Sauski/Talon/kicad-slim/images/hand.png

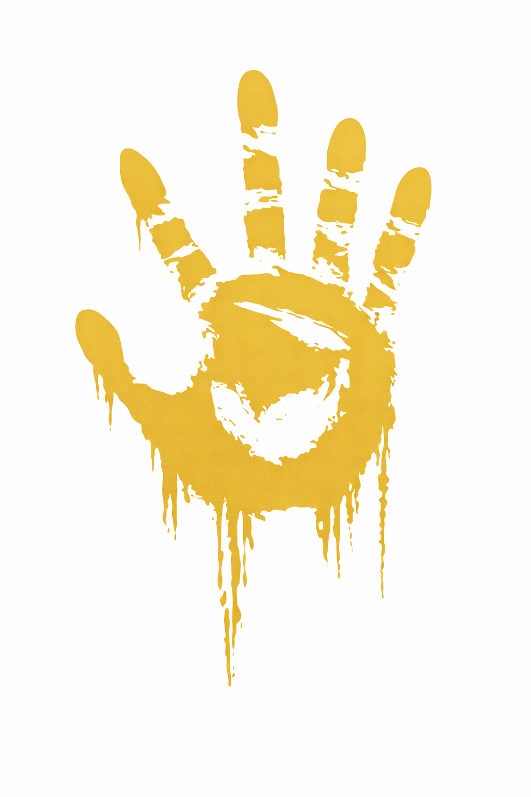
kicad-slim/images/hand.png
