Sauski/Talon/freecad/talon.FCStd

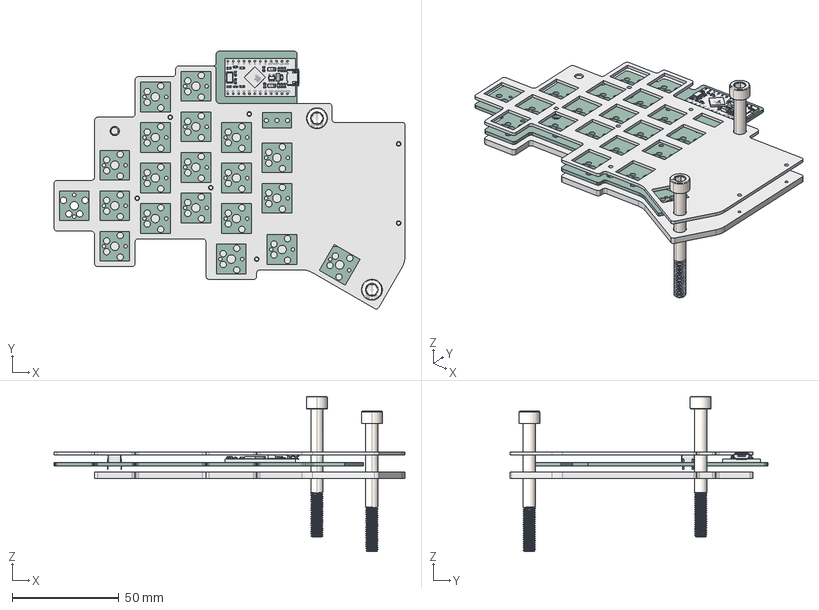
[picture p2: CAD file, 2024-05-12]
freecad/talon.FCStd
164.5 x 120.9 x 72.7 mm
Keyplate_Extrude
Baseplate_Extrude
ARDUINO PRO MICRO
SW_PUSH_6mm
talon PCB
Socket cap head bolt - short thread M6x60
Socket cap head bolt - short thread M6x061
