Sauski/Talon/kicad-slim/models/SSSS811101.step

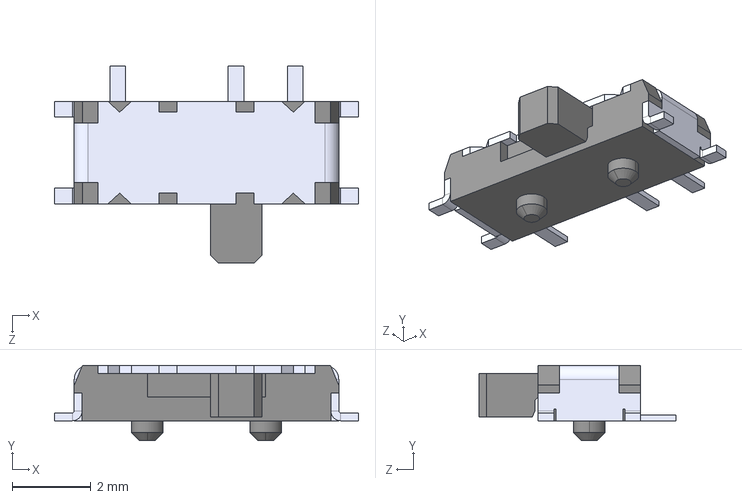
[picture p3: CAD file, 2025-10-08]
kicad-slim/models/SSSS811101.step
7.70 x 1.90 x 5.00 mm
