Sauski/Talon/freecad/talon-Keyplate_Extrude.step

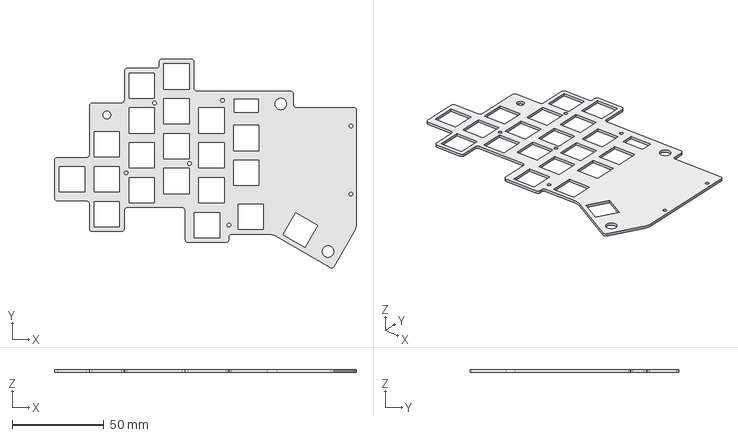
[picture p4: CAD file, 2024-05-01]
freecad/talon-Keyplate_Extrude.step
164.5 x 113.9 x 1.50 mm
