Sauski/Talon/kicad-slim/models/cherry_r2_1_25u.step

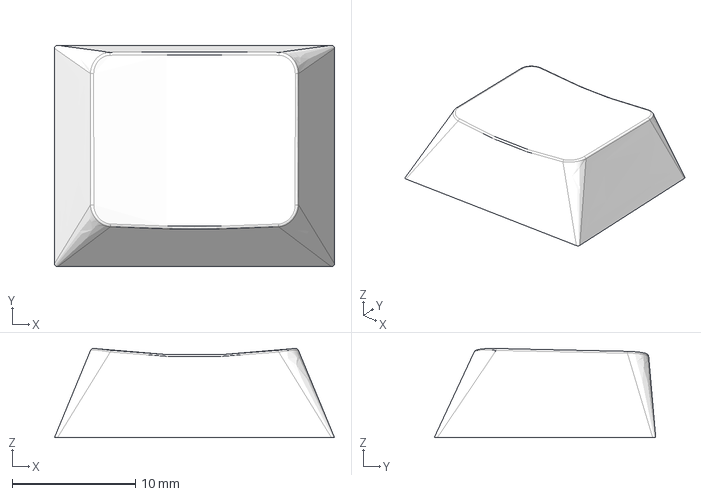
[picture p5: CAD file, 2024-04-27]
kicad-slim/models/cherry_r2_1_25u.step
22.8 x 18.0 x 7.24 mm
