Sauski/Talon/freecad/talon-Baseplate_Extrude.step

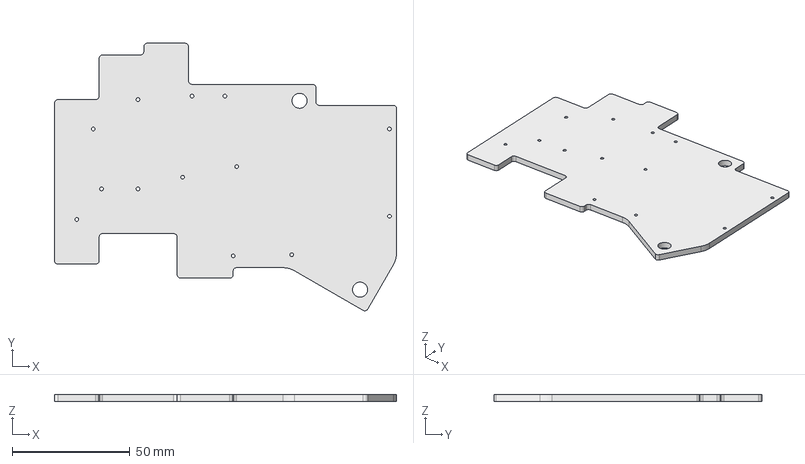
[picture p6: CAD file, 2024-05-01]
freecad/talon-Baseplate_Extrude.step
145.5 x 113.9 x 3.00 mm
