Sauski/Talon/kicad-slim/models/cherry_r2_1u.step

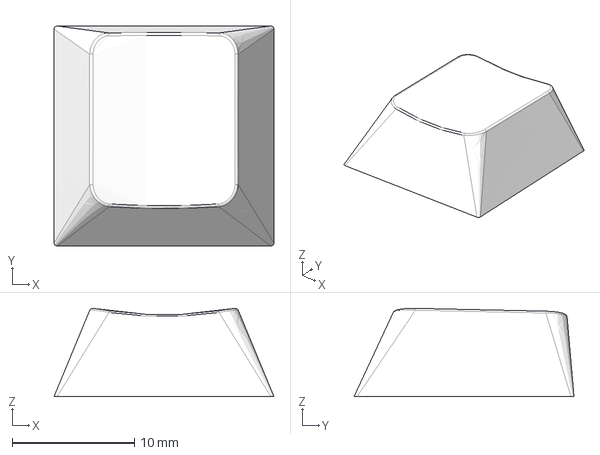
[picture p7: CAD file, 2024-04-27]
kicad-slim/models/cherry_r2_1u.step
18.0 x 18.0 x 7.23 mm
