Sauski/Talon/kicad-slim/models/cherry_r2_1_5u.step

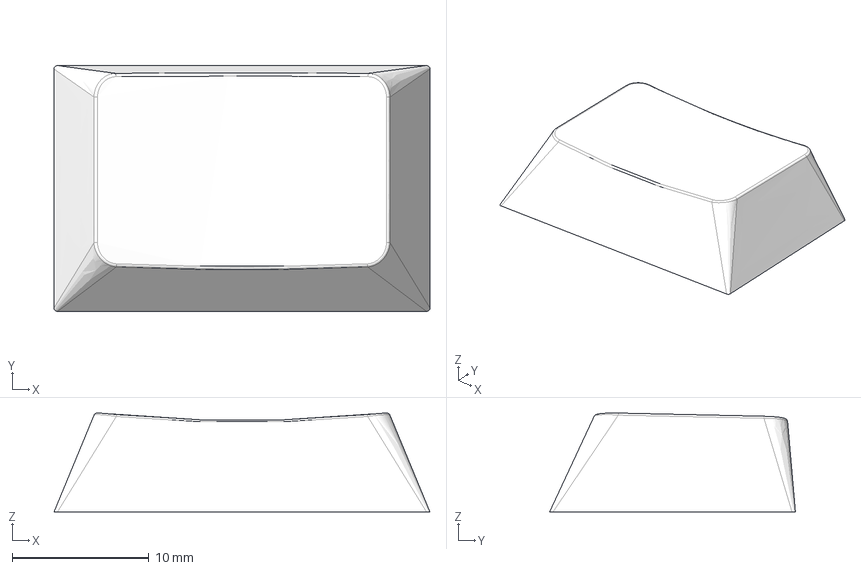
[picture p8: CAD file, 2024-04-27]
kicad-slim/models/cherry_r2_1_5u.step
27.5 x 18.0 x 7.25 mm
