Sauski/Talon/kicad-slim/talon_slim.kicad_pcb

## KiCad design kicad-slim/talon_slim.kicad_pcb (2026-01-20)

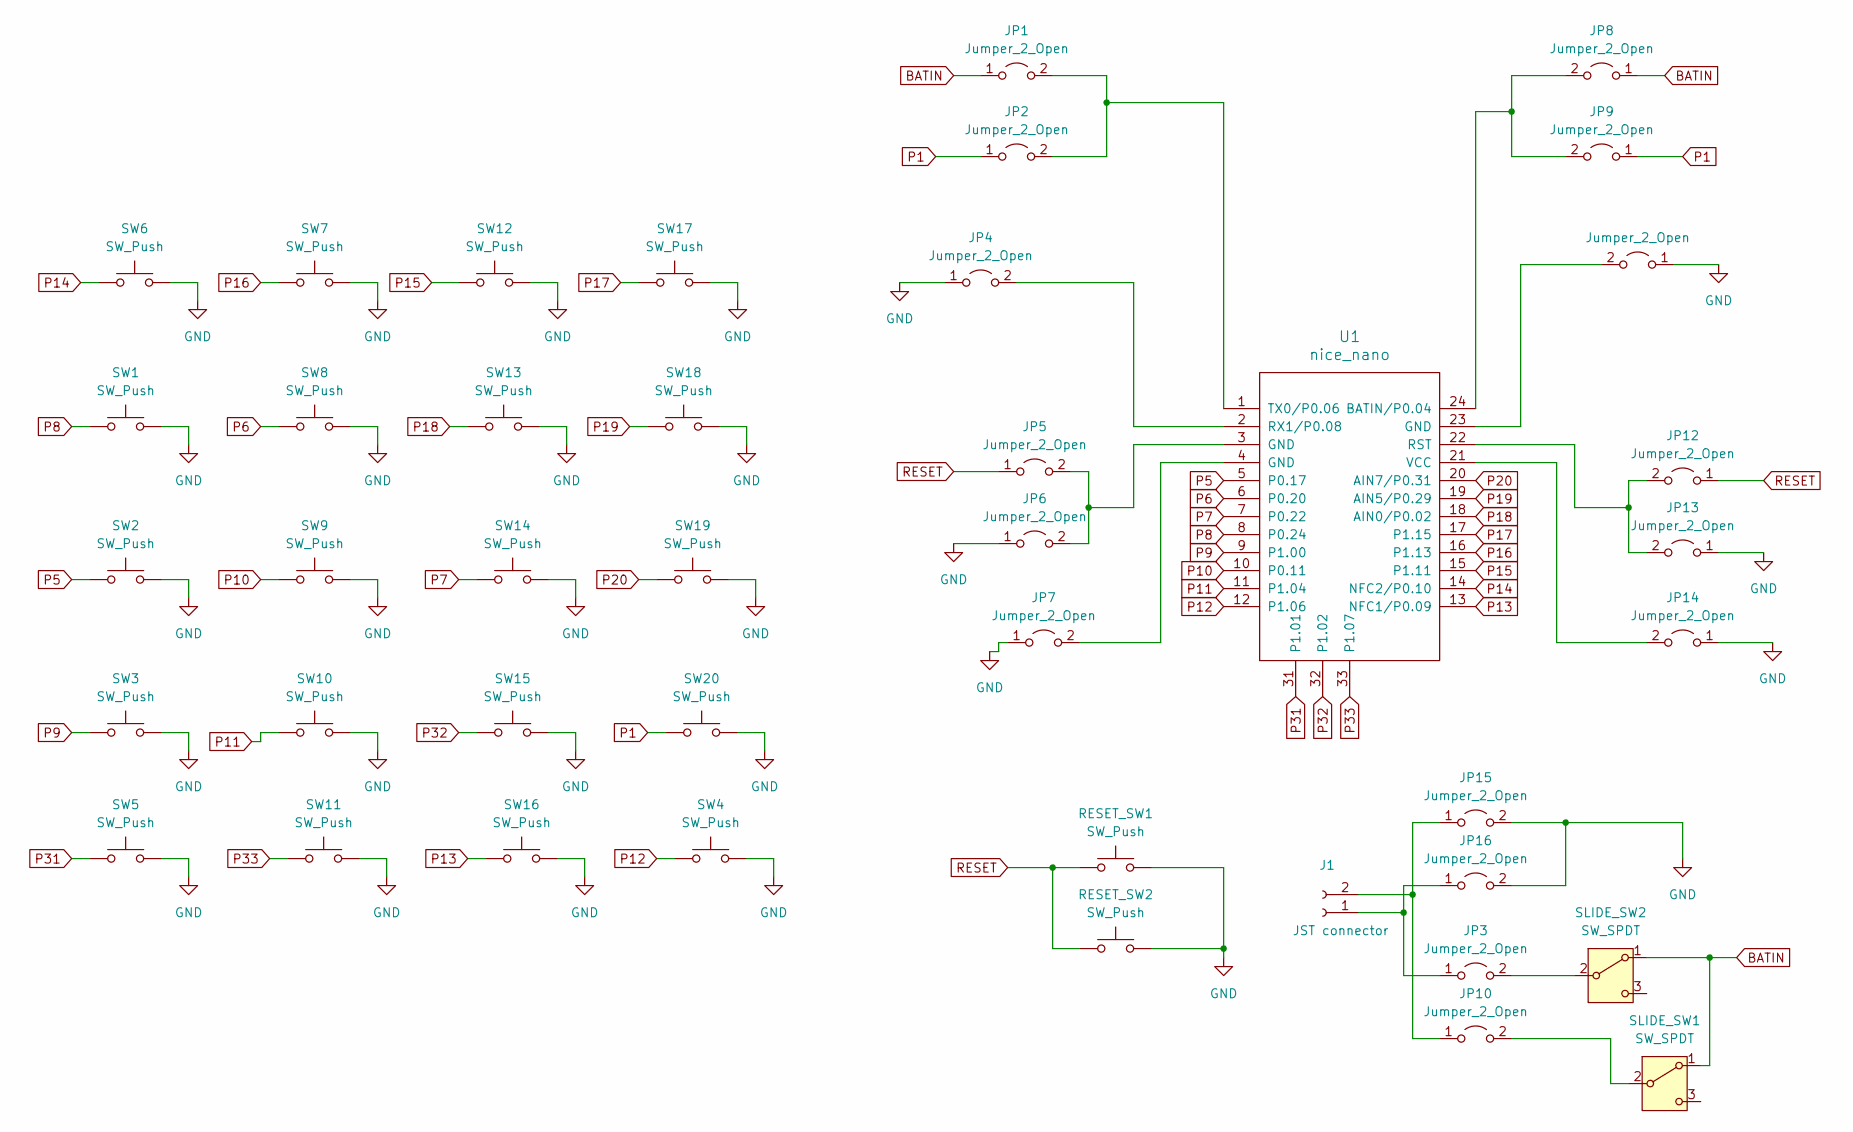
[picture p9: schematic talon_slim.kicad_sch]

Parts:
J1: JST connector; JST_PH_S2B-PH-K_1x02_P2.00mm_Horizontal
JP1, JP2, JP8, JP9: Jumper_2_Open; Jumper_Open_0.8mm
JP3, JP4, JP5, JP6, JP7, JP10, JP11, JP12, JP13, JP14, JP15, JP16: Jumper_2_Open; Jumper_Open_0.5mm
RESET_SW1, RESET_SW2: SW_Push; Panasonic_EVQPUL_EVQPUC
SLIDE_SW1, SLIDE_SW2: SW_SPDT; SW_SSSS811101
SW1, SW2, SW3, SW4, SW5, SW6, SW7, SW9, SW10, SW11, SW12, SW13, SW14, SW15, SW16, SW17, SW19, SW20: SW_Push; SW_PG1350_reversible
SW8, SW18: SW_Push; SW_PG1350_reversible_1.5U
U1: nice_nano

Connections:
BATIN: JP1.1 (A), JP8.1 (A), SLIDE_SW1.1 (A), SLIDE_SW2.1 (A)
GND: JP4.1 (A), JP6.1 (A), JP7.1 (A), JP11.1 (A), JP13.1 (A), JP14.1 (A), JP15.2 (B), JP16.2 (B), RESET_SW1.2, RESET_SW2.2, SW1.2, SW2.2, SW3.2, SW4.2, SW5.2, SW6.2, SW7.2, SW8.2, SW9.2, SW10.2, SW11.2, SW12.2, SW13.2, SW14.2, SW15.2, SW16.2, SW17.2, SW18.2, SW19.2, SW20.2
unnamed: J1.1, JP3.1 (A), JP16.1 (A)
unnamed: J1.2, JP10.1 (A), JP15.1 (A)
unnamed: JP1.2 (B), JP2.2 (B), U1.1 (TX0/P0.06)
unnamed: JP3.2 (B), SLIDE_SW2.2 (B)
unnamed: JP4.2 (B), U1.2 (RX1/P0.08)
unnamed: JP5.2 (B), JP6.2 (B), U1.3 (GND)
unnamed: JP7.2 (B), U1.4 (GND)
unnamed: JP8.2 (B), JP9.2 (B), U1.24 (BATIN/P0.04)
unnamed: JP10.2 (B), SLIDE_SW1.2 (B)
unnamed: JP11.2 (B), U1.23 (GND)
unnamed: JP12.2 (B), JP13.2 (B), U1.22 (RST)
unnamed: JP14.2 (B), U1.21 (VCC)
P1: JP2.1 (A), JP9.1 (A), SW20.1
P5: SW2.1, U1.5 (P0.17)
P6: SW8.1, U1.6 (P0.20)
P7: SW14.1, U1.7 (P0.22)
P8: SW1.1, U1.8 (P0.24)
P9: SW3.1, U1.9 (P1.00)
P10: SW9.1, U1.10 (P0.11)
P11: SW10.1, U1.11 (P1.04)
P12: SW4.1, U1.12 (P1.06)
P13: SW16.1, U1.13 (NFC1/P0.09)
P14: SW6.1, U1.14 (NFC2/P0.10)
P15: SW12.1, U1.15 (P1.11)
P16: SW7.1, U1.16 (P1.13)
P17: SW17.1, U1.17 (P1.15)
P18: SW13.1, U1.18 (AIN0/P0.02)
P19: SW18.1, U1.19 (AIN5/P0.29)
P20: SW19.1, U1.20 (AIN7/P0.31)
P31: SW5.1, U1.31 (P1.01)
P32: SW15.1, U1.32 (P1.02)
P33: SW11.1, U1.33 (P1.07)
RESET: JP5.1 (A), JP12.1 (A), RESET_SW1.1, RESET_SW2.1

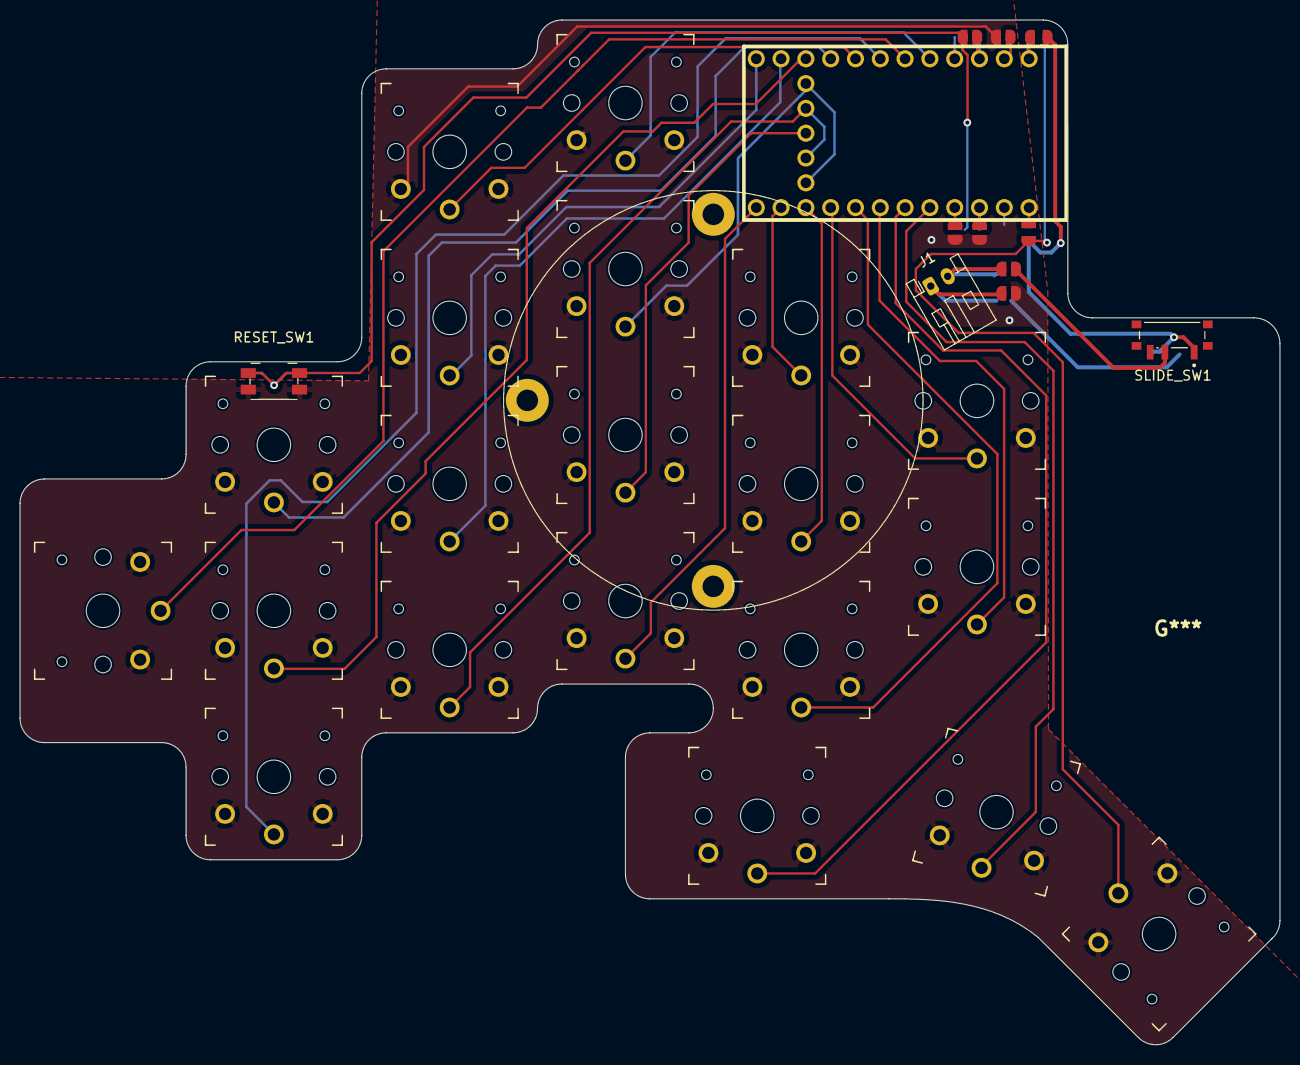
[picture p10: board talon_slim.kicad_pcb from above]

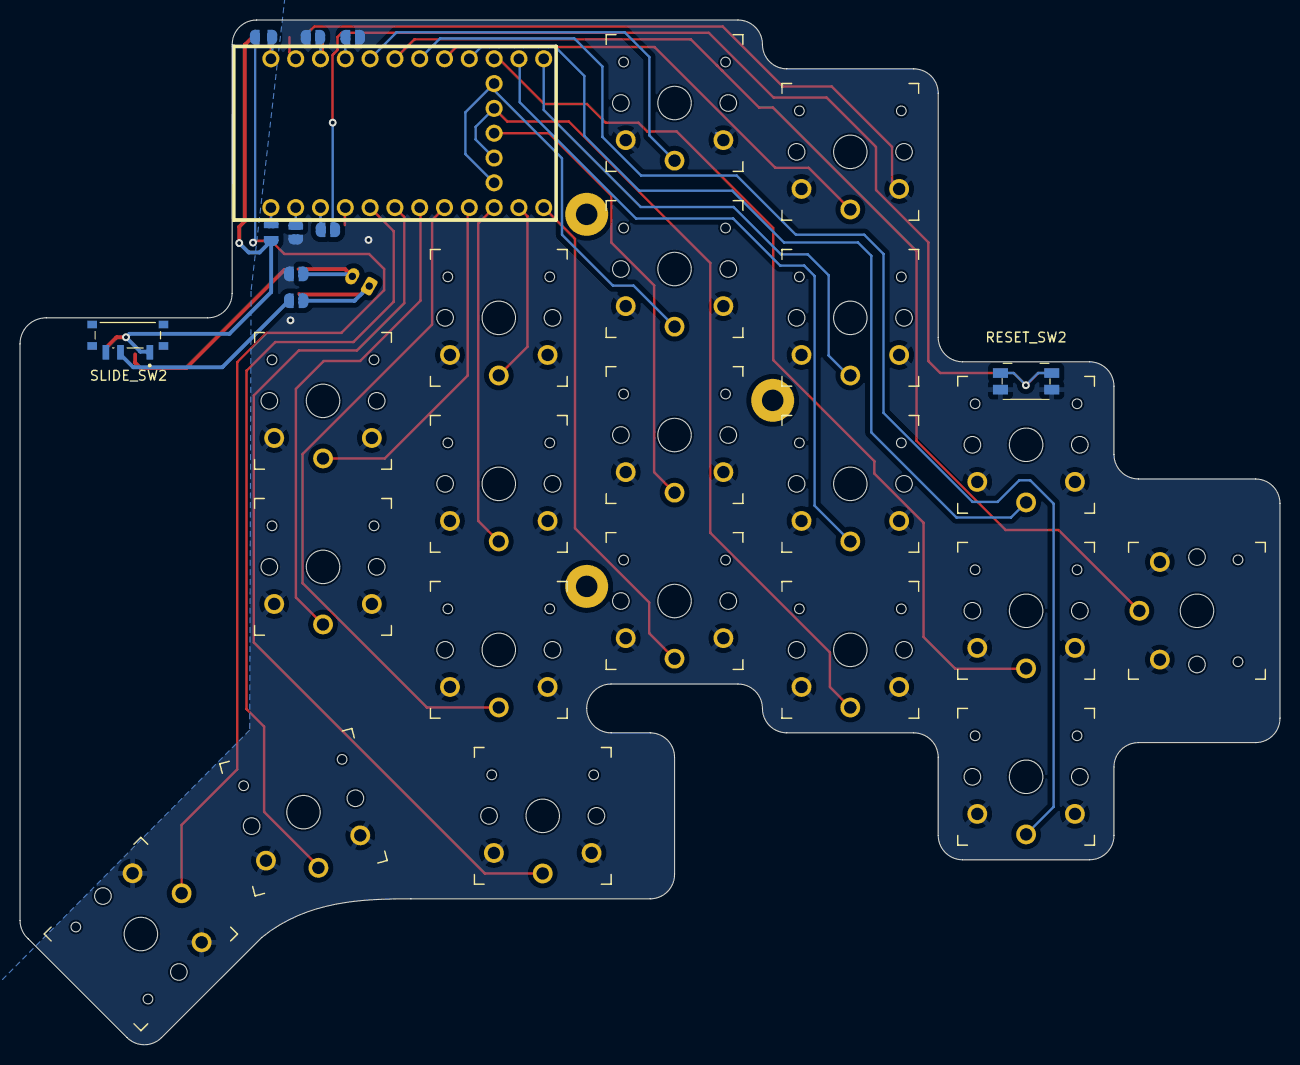
[picture p11: board talon_slim.kicad_pcb from below]

Board: 2 copper layers, 129.0 x 104.9 mm, 42 parts (10 on the bottom side), 35 nets.
