Sauski/Talon/(commit log)

2024-04-27 Initial sketch
    [cherry_r2_1_25u.step, cherry_r2_1_5u.step, cherry_r2_1u.step, talon.kicad_pcb, talon.kicad_sch]
2024-04-28 getting pretty tasty!
    [talon.FCStd, talon.kicad_pcb]
2024-04-28 fully constrained key plate
    [talon.FCStd]
2024-04-28 add fillets to keyplate
    [talon.FCStd]
2024-04-28 added fillet to pcb
    [talon.kicad_pcb]
2024-04-28 working on routing
    Battery connection gnd is disconnected from fill.
    [talon.FCStd, talon.kicad_pcb, talon.kicad_sch]
2024-04-28 PCB seems legit
    [talon.kicad_pcb]
2024-05-01 v1 sent for production
    [talon-Baseplate_Extrude.step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]
2024-05-12 Added json and started keymap
    [talon.FCStd, talon.kicad_pcb]
2024-05-18 Keymap feeling pretty good
    Turns out curling the pinky is better
    Turns out curling the fingers is better.
    Fuck.
2024-12-25 Add the Alternative International keyboard dee el els
2025-10-08 thinking about slim
    [SSSS811101.step, cherry_r2_1_25u.step, cherry_r2_1_5u.step, cherry_r2_1u.step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]
2026-01-19 Slim looking not tooooo bad
    [talon-B_Cu.gbr, talon-B_Mask.gbr, talon-B_Paste.gbr, talon-B_Silkscreen.gbr, talon-Edge_Cuts.gbr, talon-F_Cu.gbr, talon-F_Mask.gbr, talon-F_Paste.gbr]
2026-01-20 sent slim for procuction
    [talon_slim-B_Cu.gbr, talon_slim-B_Mask.gbr, talon_slim-B_Paste.gbr, talon_slim-Edge_Cuts.gbr, talon_slim-F_Cu.gbr, talon_slim-F_Mask.gbr, talon_slim-F_Paste.gbr, talon_slim-NPTH.drl]
